W8jonas/pluviografo/Imagens/IMG-20181021-WA0015.jpg

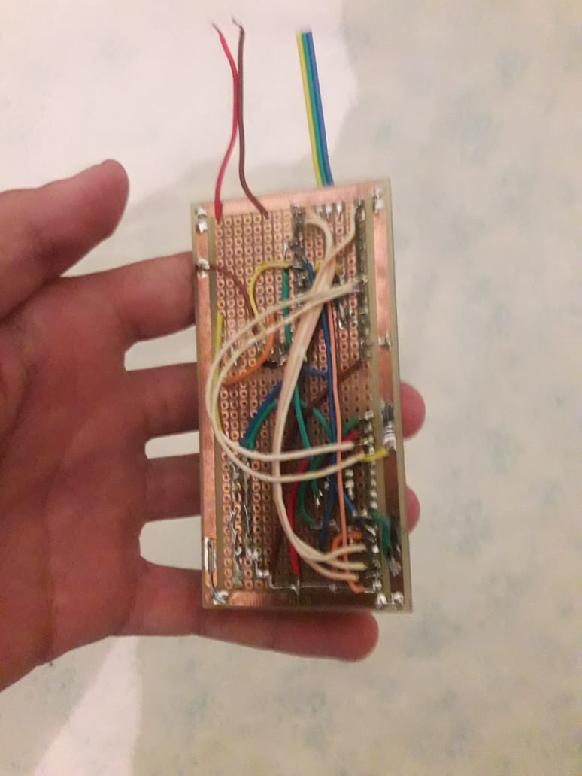
Imagens/IMG-20181021-WA0015.jpg
