W8jonas/pluviografo/Imagens/20180808_182946.jpg

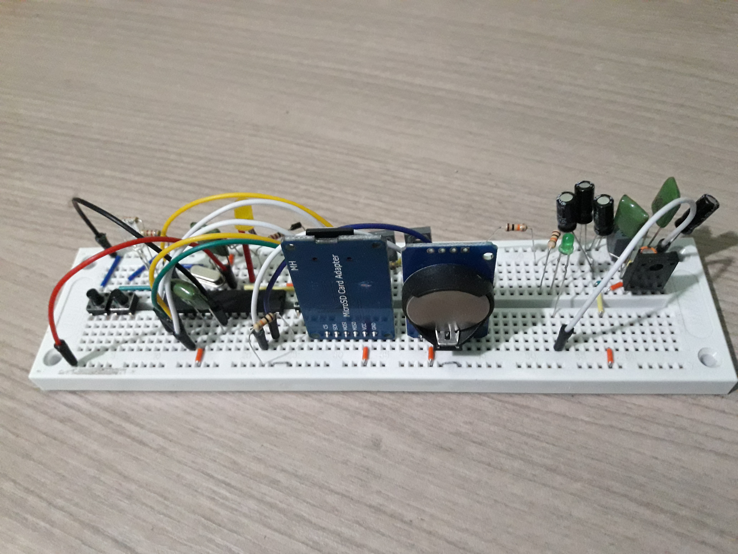
Imagens/20180808_182946.jpg
