W8jonas/pluviografo/Imagens/consumo energia esquema grafico por tempo.png

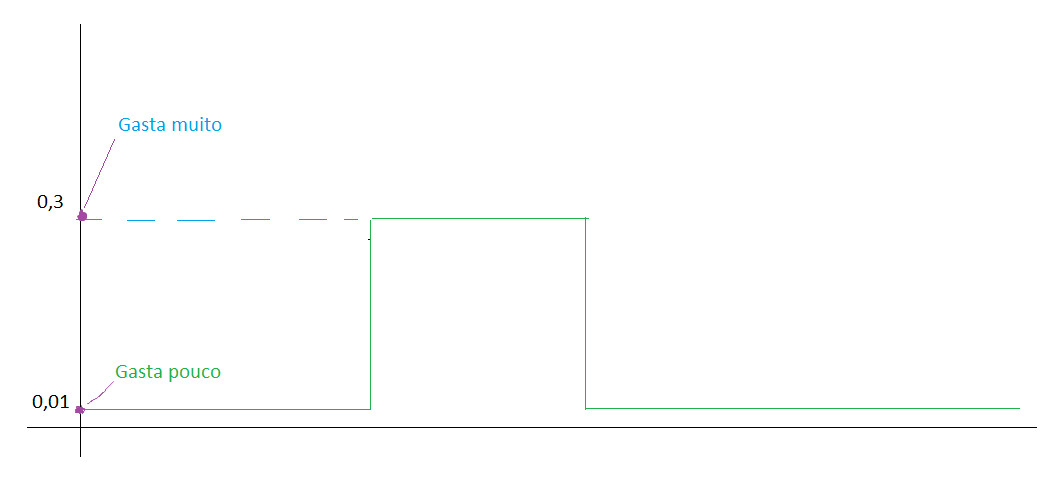
Imagens/consumo energia esquema grafico por tempo.png
