W8jonas/pluviografo/Imagens/IMG-20180818-WA0000.jpg

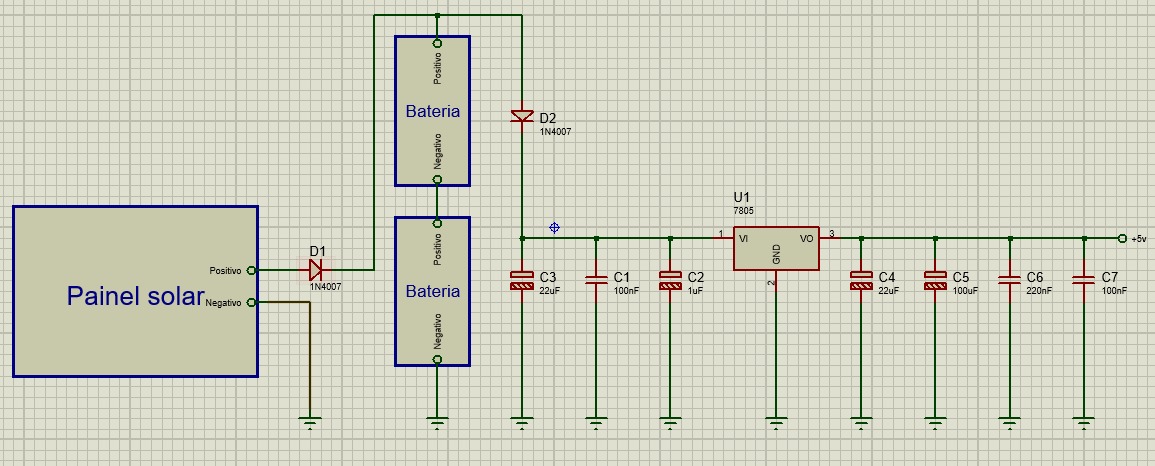
Imagens/IMG-20180818-WA0000.jpg
