W8jonas/pluviografo/Imagens/IMG-20180930-WA0047.jpeg

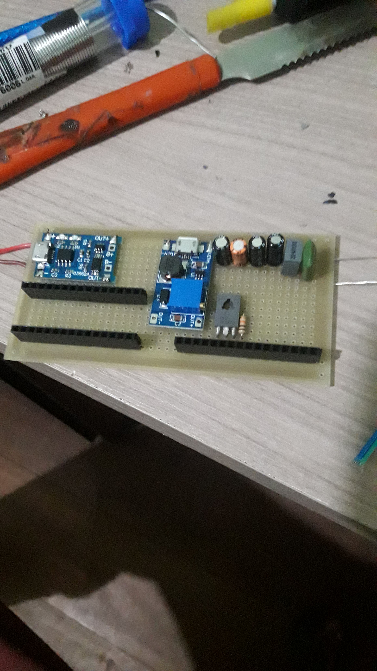
Imagens/IMG-20180930-WA0047.jpeg
