W8jonas/pluviografo/Imagens/IMG-20180930-WA0050.jpg

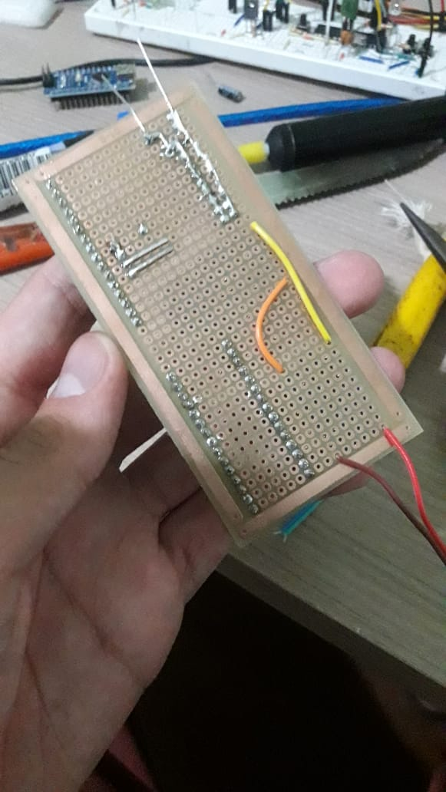
Imagens/IMG-20180930-WA0050.jpg
