W8jonas/pluviografo/Imagens/IMG-20181021-WA0011.jpg

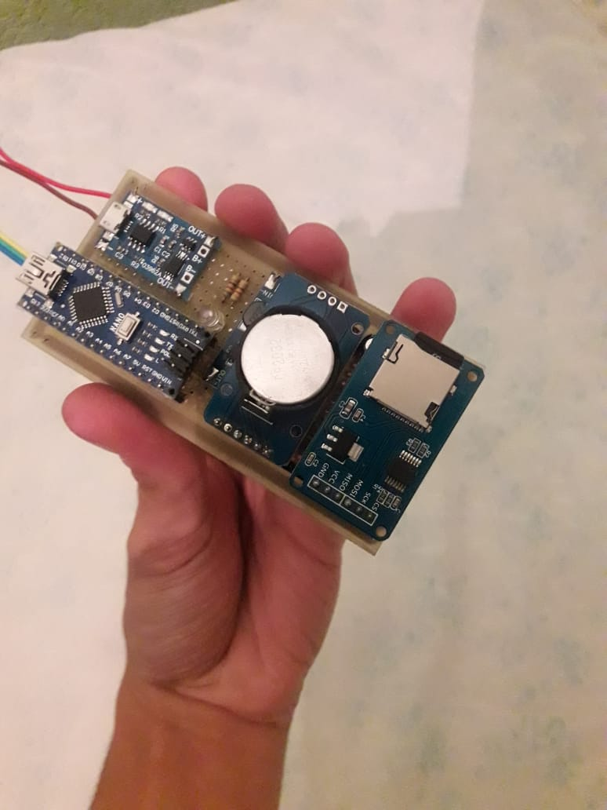
Imagens/IMG-20181021-WA0011.jpg
