W8jonas/pluviografo/Imagens/IMG-20181022-WA0033.jpg

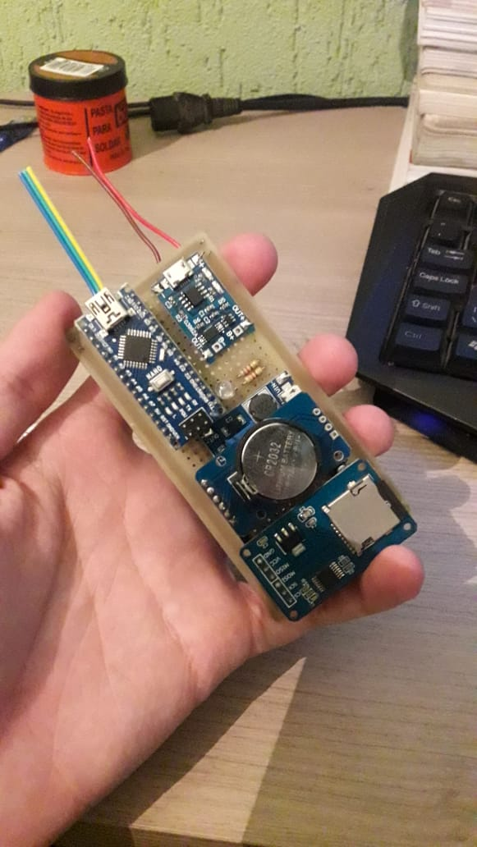
Imagens/IMG-20181022-WA0033.jpg
