W8jonas/pluviografo/programacao/add_low-power_cmd_v2.0_0/add_low-power_deepsleep_cmd - v2/readme.jpg

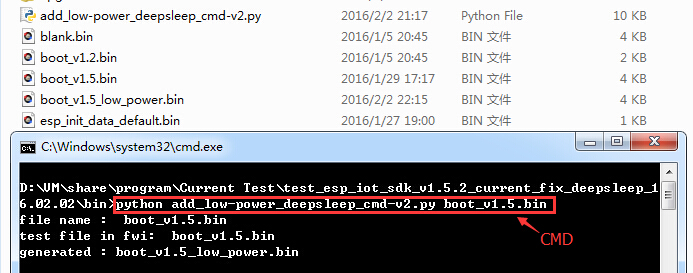
programacao/add_low-power_cmd_v2.0_0/add_low-power_deepsleep_cmd - v2/readme.jpg
