W8jonas/pluviografo/projeto pluviógrafo diagrama de blocos.png

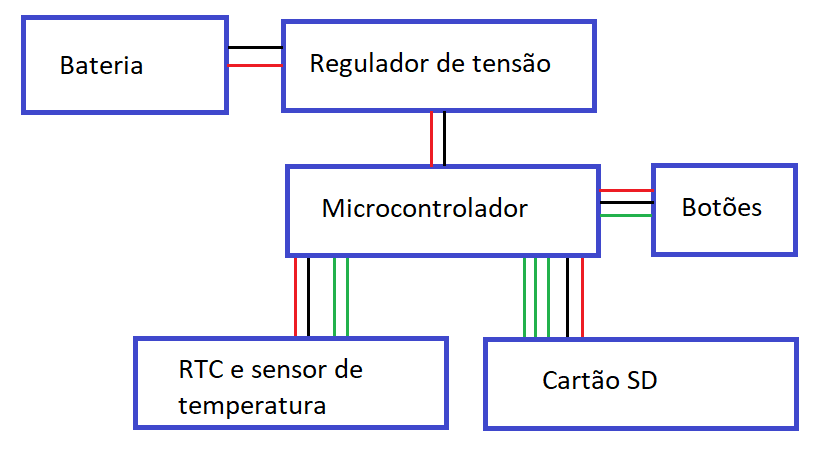
projeto pluviógrafo diagrama de blocos.png
