W8jonas/pluviografo/projeto pluviógrafo esquemático.PDF

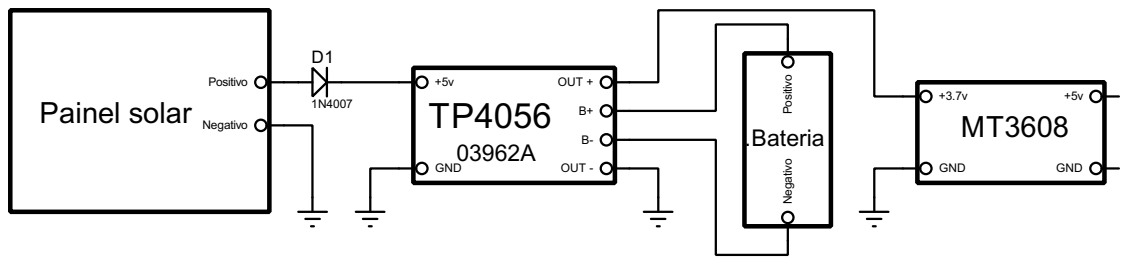
[picture p34: page 1]

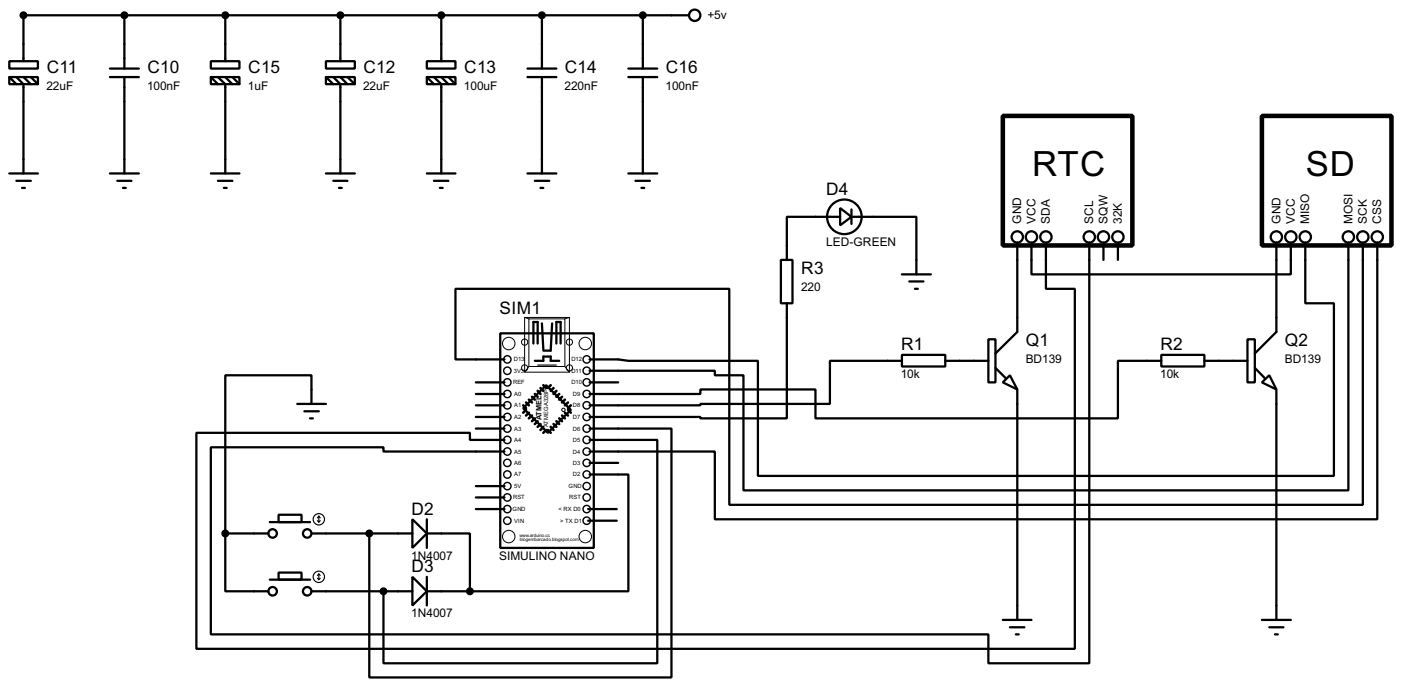
[picture p35: page 2]
