W8jonas/pluviografo/(list of files, drawings)

Other design files:
projeto pluviógrafo esquemático.pdsprj
