W8jonas/pluviografo/(commit log)

2018-07-22 Att de codigo -- simples
2018-08-09 Up de 1.1 e imagem de consumo energia
2018-08-14 Att de arquivo para reuniao
2018-10-22 Att de softwar; montagem da placa de circuito impresso
2018-10-26 Troca de nome arquivo grande
2018-10-26 Troca de nome de pasta
2018-10-26 Troca de nomes novamete
2018-10-30 Nova versao de codigo - 1.3 e att em 1.2
2019-02-12 Data de ultima alteracao: 26/01/2019
    [projeto pluviógrafo esquemático.pdsprj]
